Rodolfo855/ClassD/Project Pictures/IMG_4157.jpg

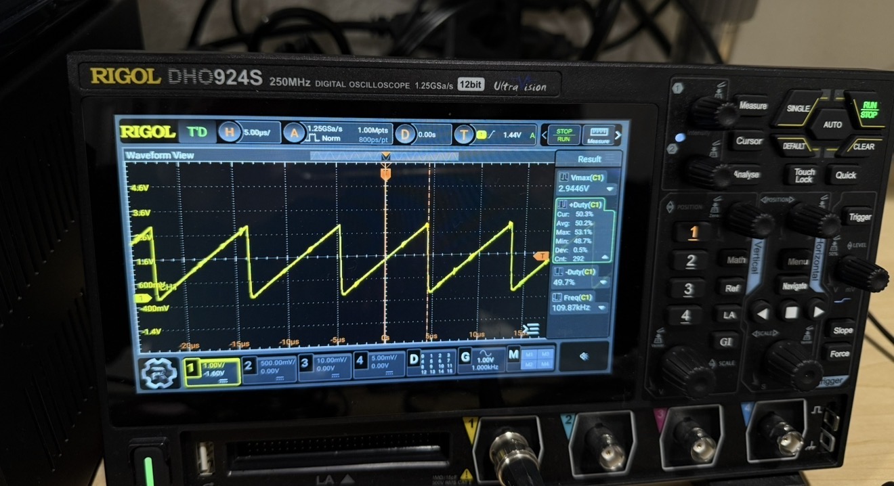
Project Pictures/IMG_4157.jpg
