Rodolfo855/ClassD/Project Pictures/IMG_4158.jpg

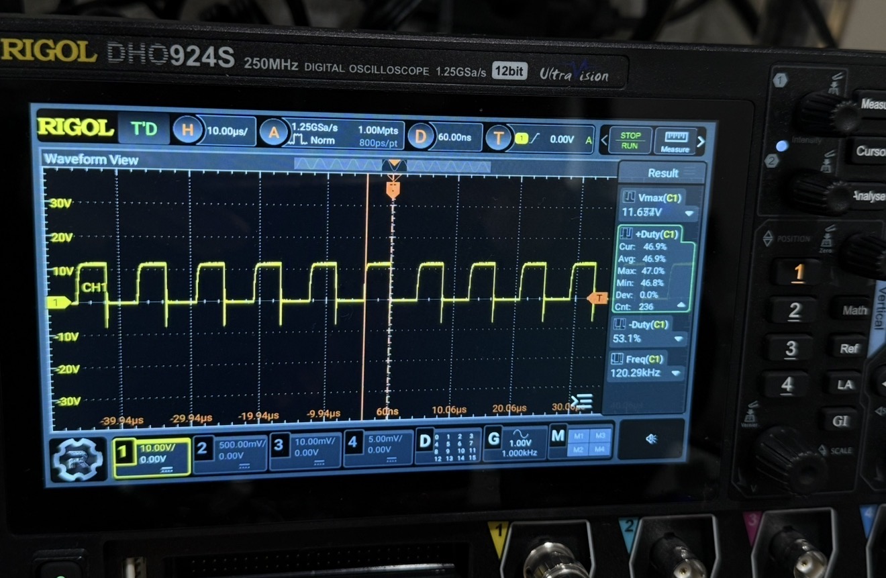
Project Pictures/IMG_4158.jpg
