Rodolfo855/ClassD/Write-Up/ENGG220 Final -Write up.pdf

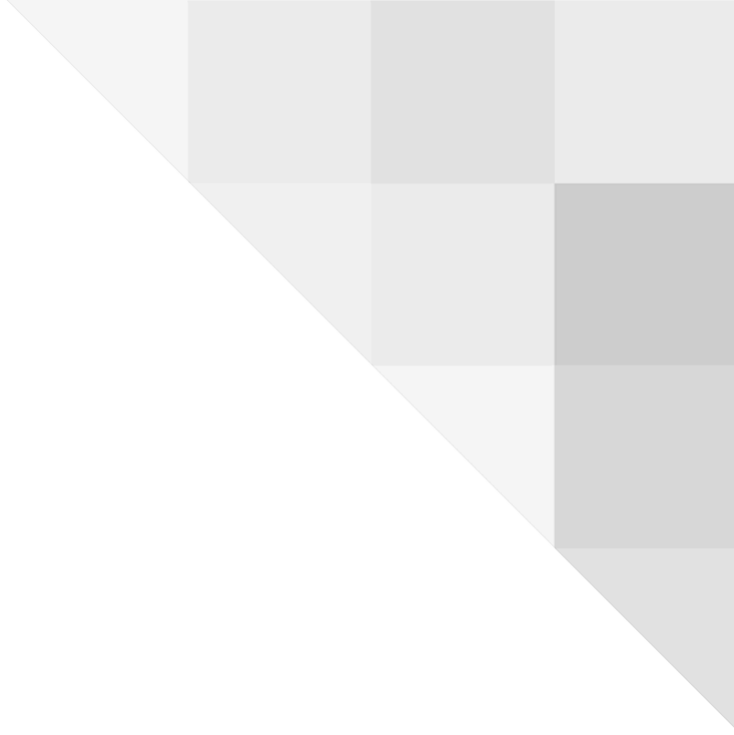
[picture p3: figure]

# Victor Rosales

College of Marin

# ENGG220 Final Project

05/11/2026

# Project Overview

For my final project I built a high-efficiency Class D Amplifier based on the Mundo Electronica design. This project required me to dive deeper into audio filtering and generation of pulse width modulation signals. In addition, I needed to calculate input impedances, components values, and bode plots using LTSpice software . Also, this project required me to read and understand data sheets for integrated circuits.

## Pulse Width Modulation (PWM)

Based on the TL494 (IC) we can generate a sawtooth signal that oscillates between 0 and 3V, which then is compared to the audio signal to generate a PWM signal. I am using a single ended approach which means I have to ground one of the emitters (E2) to get an inverse PWM. This PWM and INV_PWM will be used by the power stage and controlled by IR2110 (IC) which will then allow N-Channel MOSFETS (IRFZ44N’s) to increase the

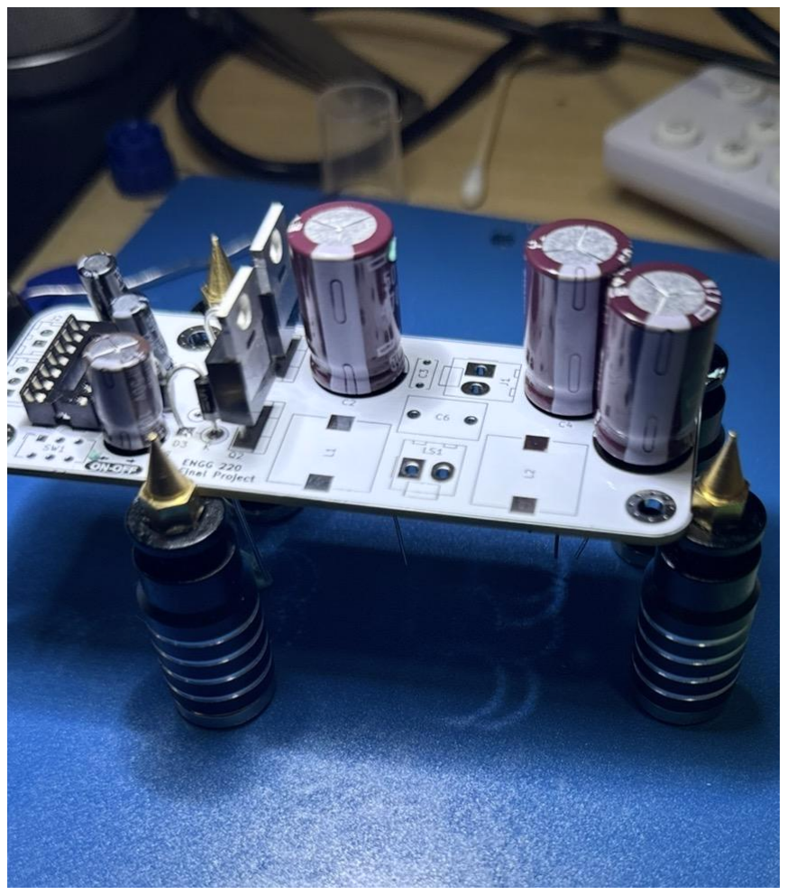
[picture p4: figure]

power output to the speaker connected. I am implementing a half-bridge topology and using a single source, which means I need a “bootstrap” circuit using IR2110 and a capacitor to give the mosfet a higher voltage than 36V (circuit max) to successfully open and close the gates.

Instructions

Given that the sawtooth generated by the TL494 oscillates between 0 and 3V we need to “submerge” or audio signal between this range. Now, there are a few ways on how to do this, but the easiest way will be to send a 1khz signal at full volume and measure with an oscilloscope the peak to peak voltage coming out of test point 7 (AUDIO). I have placed a potentiometer that will allow us to adjust the gain. When the gain is too high or above the limits of TL494 or the operational amplifier (LM358) you will experience “clipping” which I have attached a picture for you to see (and avoid).

Challenges

I used and calculated resistors that were giving me 0.1 gain for the second operational amplifier, as well as incorrect component values for high pass filters. I blew a couple of transistors and other components. Also, the audio sine wave was not oscillating between 0 and 3V it was oscillating between 2.2V and 2.6V with a peak to peak voltage of only about 400mV. I connected the IC backwards so I needed to double check pin by pin. Soldering challenges and ordering components was also a bit of a struggle and expensive.

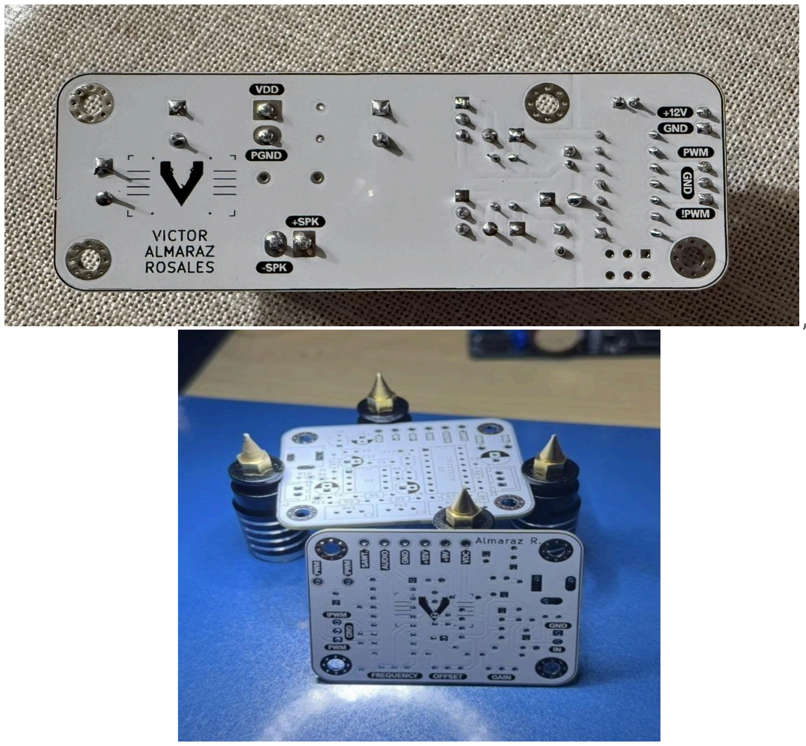
[picture p5: figure]

,

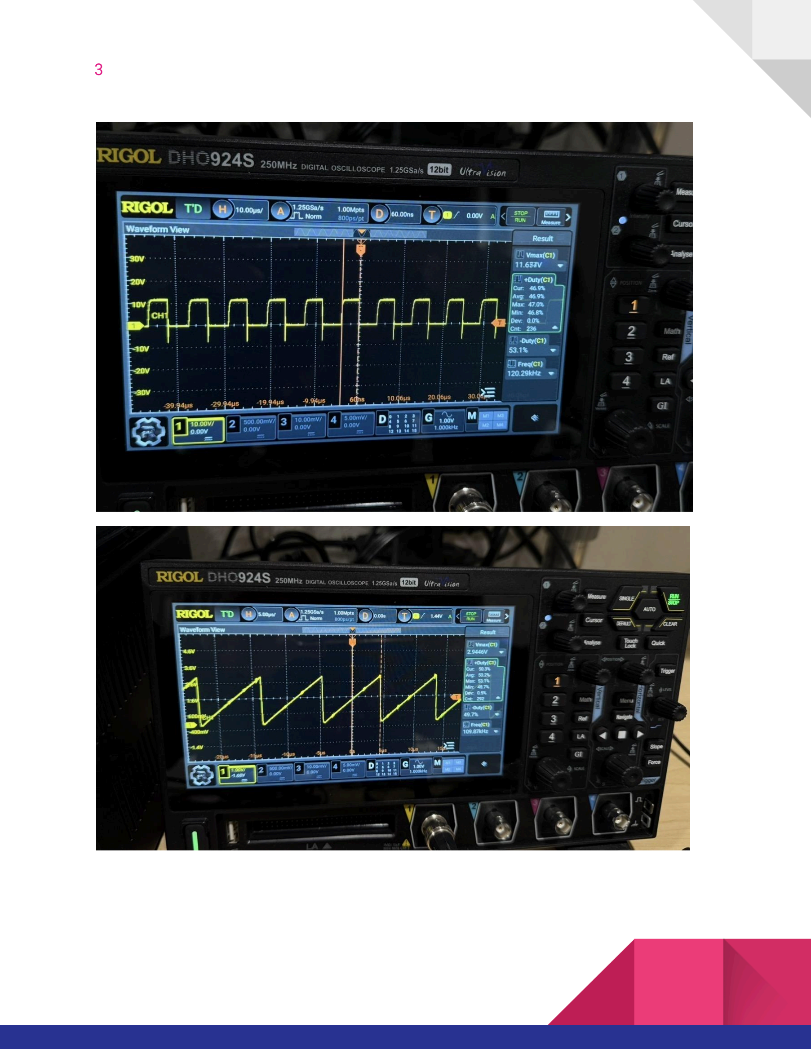
[picture p6: page 3]
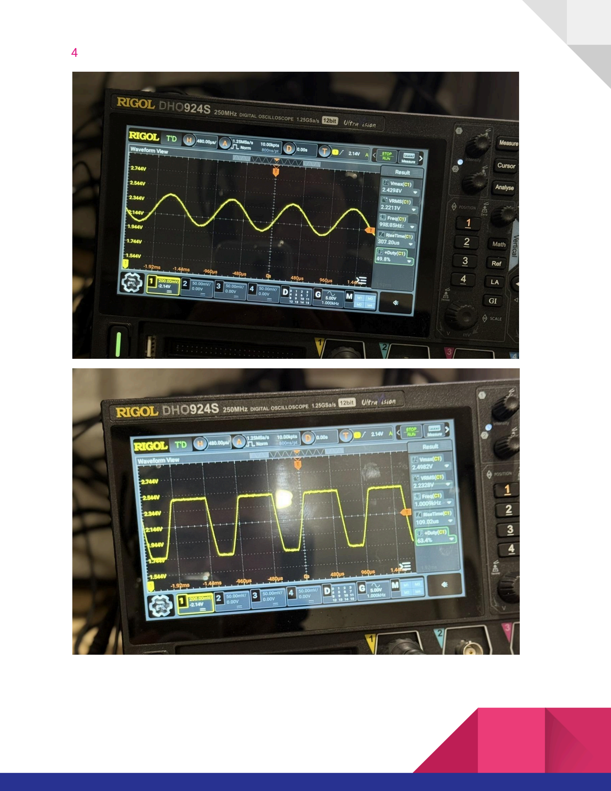
[picture p7: page 4]
