Rodolfo855/ClassD/Project Pictures/IMG_4139.jpg

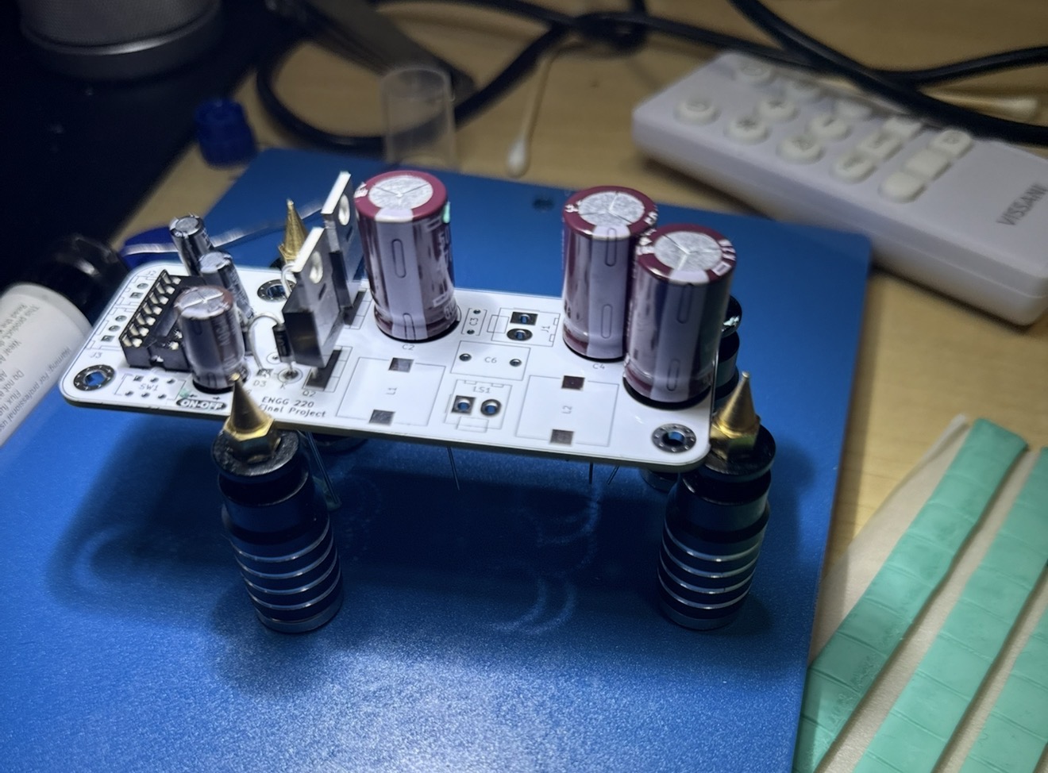
Project Pictures/IMG_4139.jpg
