Rodolfo855/ClassD/Project Pictures/IMG_4155.jpg

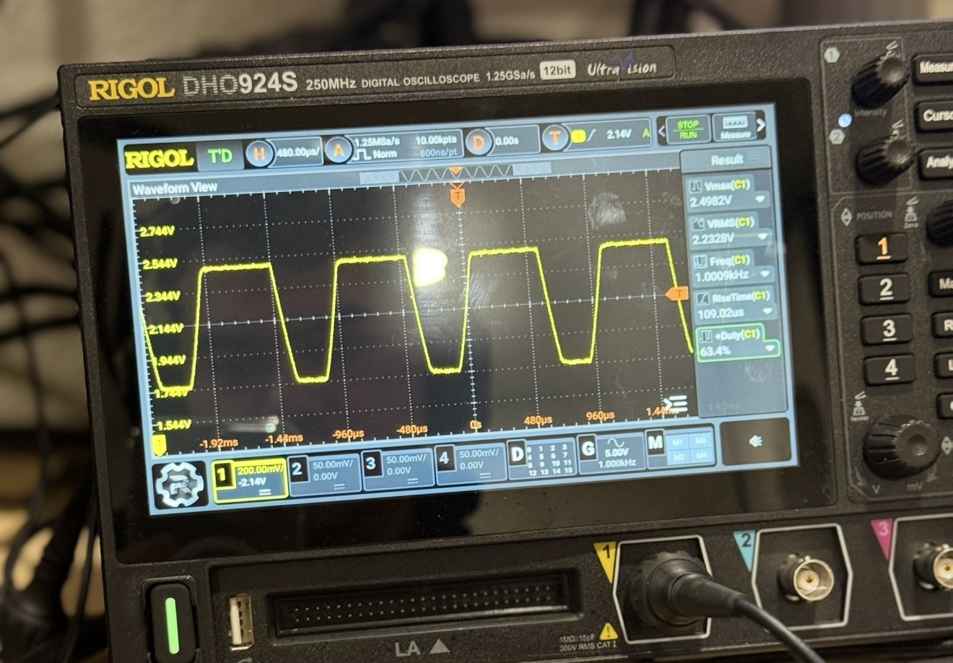
Project Pictures/IMG_4155.jpg
