Rodolfo855/ClassD/Project Pictures/IMG_4156.jpg

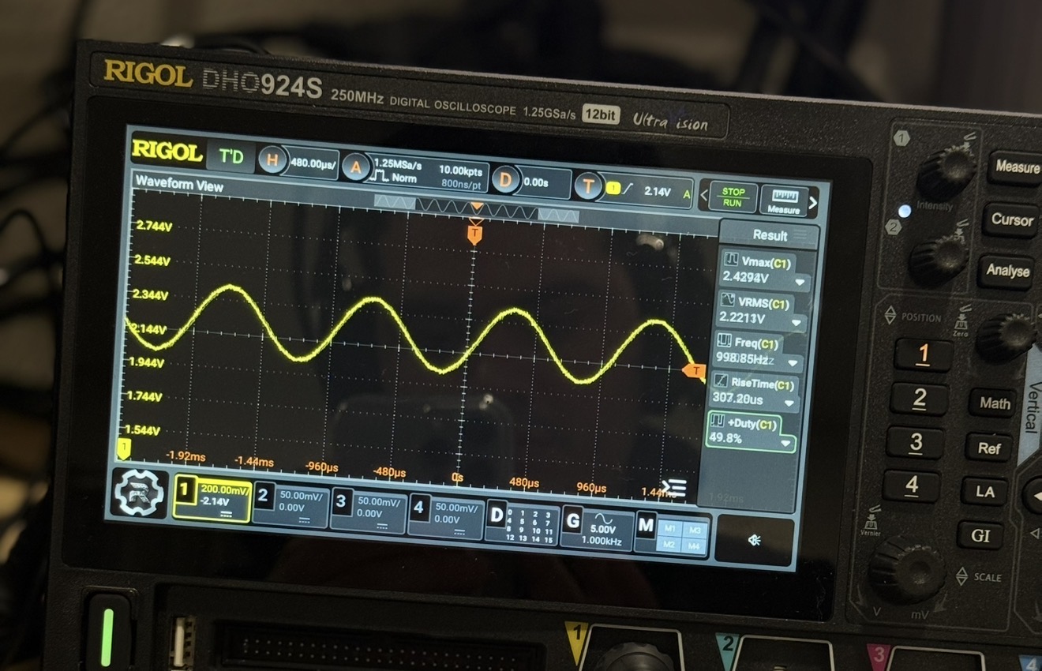
Project Pictures/IMG_4156.jpg
