Rodolfo855/ClassD/Project Pictures/IMG_4159.jpg

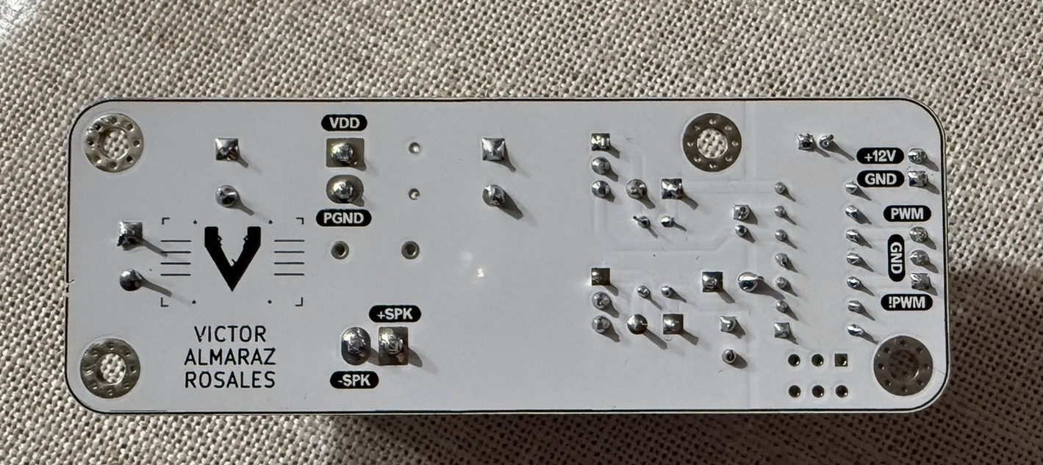
Project Pictures/IMG_4159.jpg
