Rodolfo855/ClassD/Project Pictures/IMG_4160.jpg

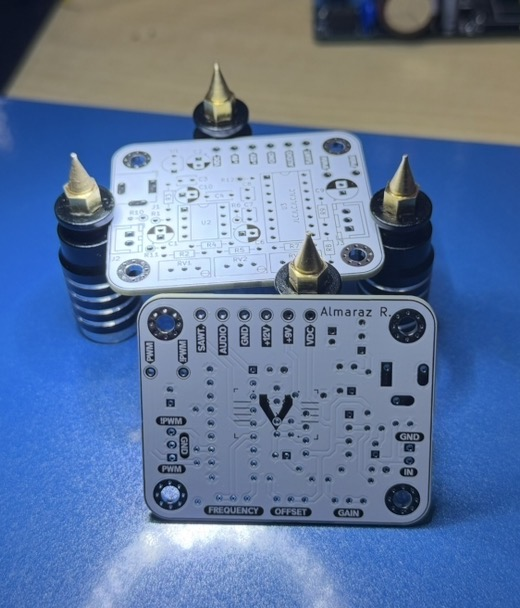
Project Pictures/IMG_4160.jpg
