Rodolfo855/ClassD/Project Pictures/Screenshot 2026-05-03 at 4.42.00 PM.png

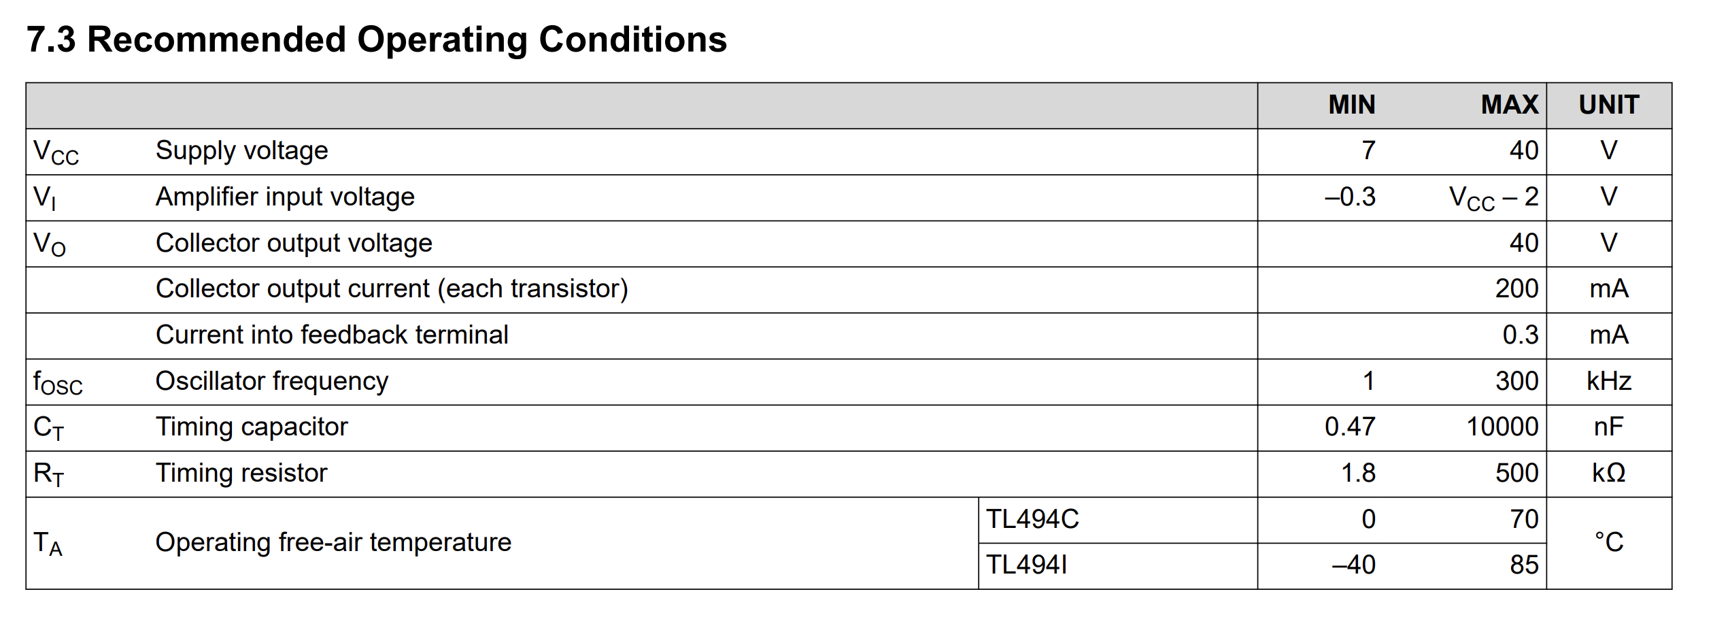
Project Pictures/Screenshot 2026-05-03 at 4.42.00 PM.png
