Rodolfo855/ClassD/Project Pictures/Screenshot 2026-05-03 at 5.14.32 PM.png

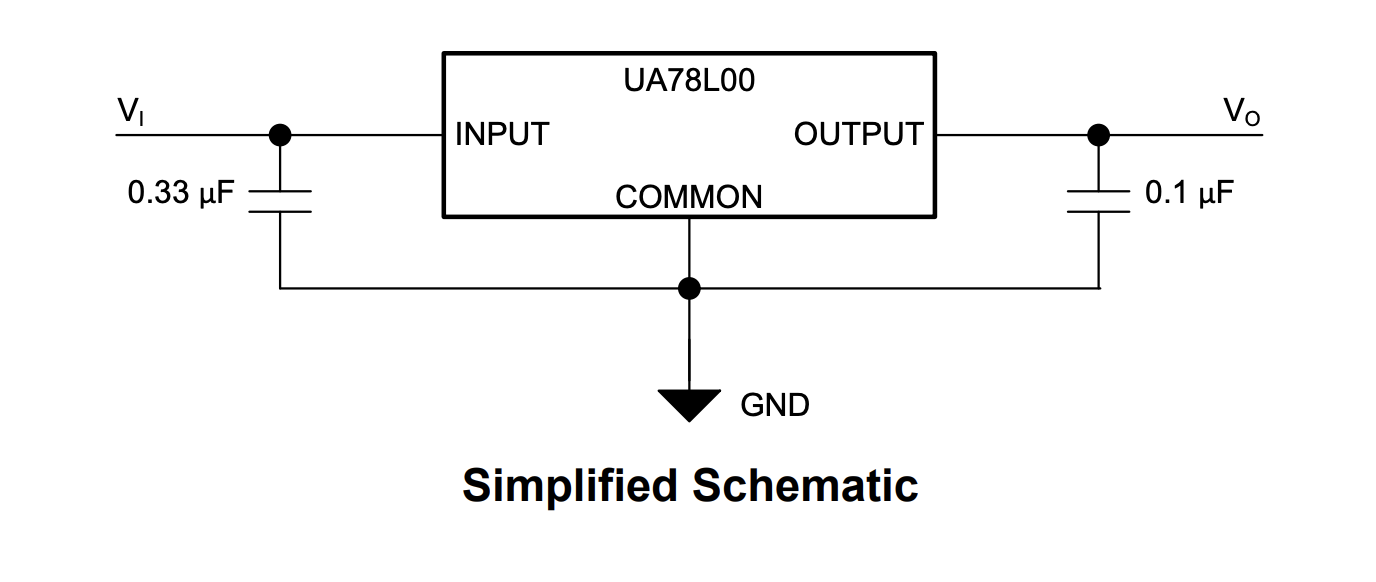
Project Pictures/Screenshot 2026-05-03 at 5.14.32 PM.png
