Rodolfo855/ClassD/Project Pictures/Screenshot 2026-05-04 002417.png

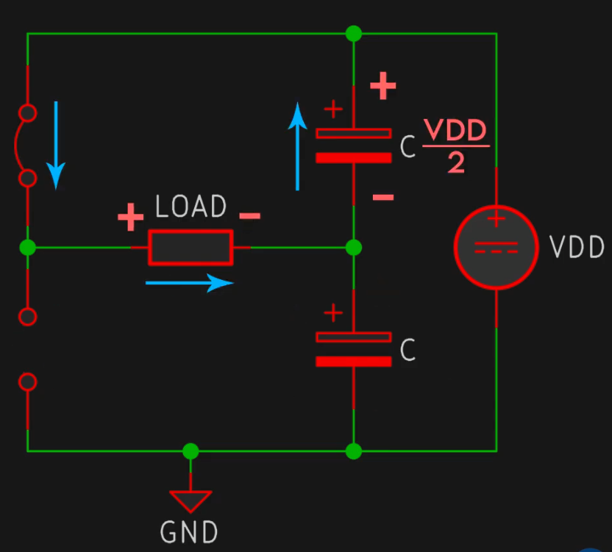
Project Pictures/Screenshot 2026-05-04 002417.png
