Rodolfo855/ClassD/Project Pictures/Screenshot 2026-05-07 at 1.02.39 AM.png

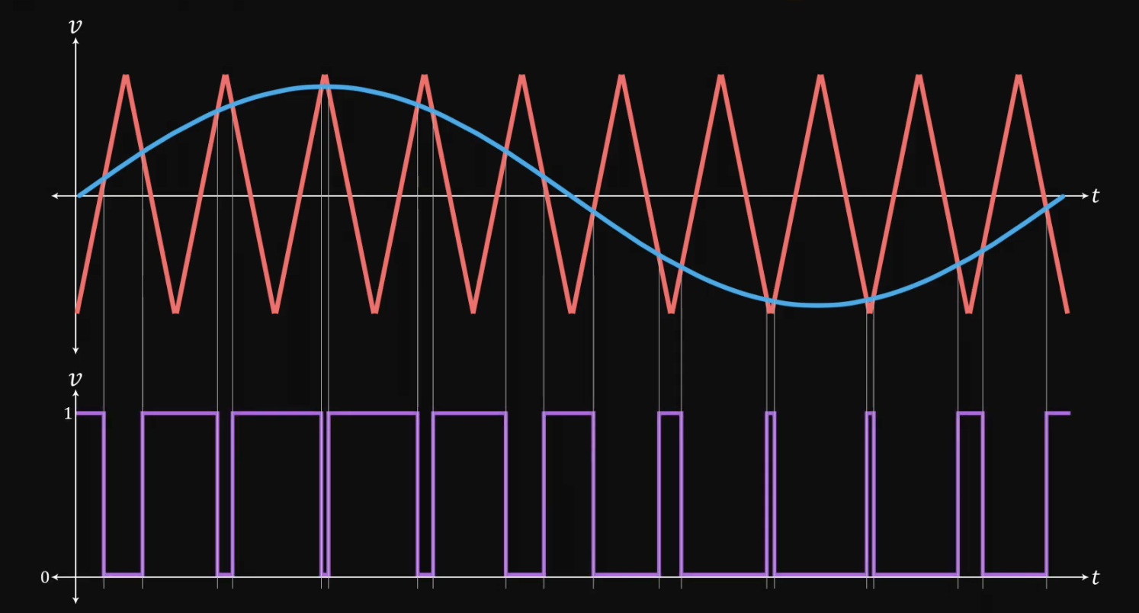
Project Pictures/Screenshot 2026-05-07 at 1.02.39 AM.png
