Rodolfo855/ClassD/Project Pictures/Screenshot 2026-05-07 at 12.59.20 AM.png

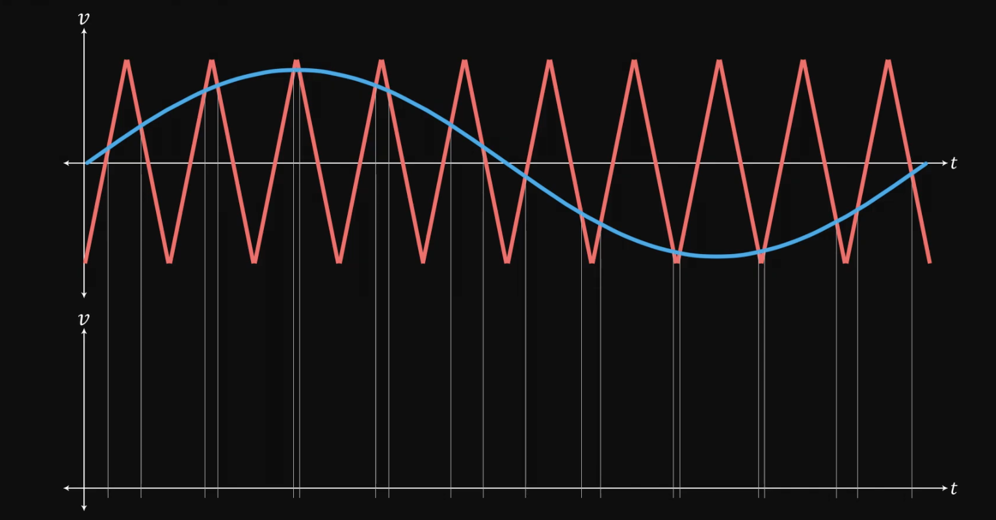
Project Pictures/Screenshot 2026-05-07 at 12.59.20 AM.png
