Rodolfo855/ClassD/PowerStage/PowerStage.pdf

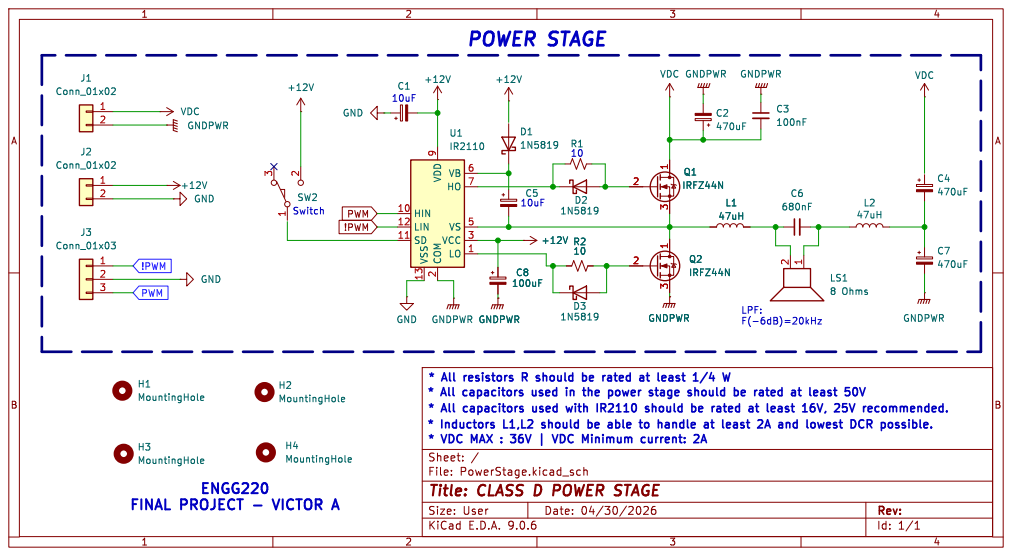
[picture p21: page 1]

2 SW2 C1 H1 MountingHole H3 MountingHole H4 MountingHole H2 MountingHole HIN 10

2 VB 6 HO 7 VS 5 VCC 3

Id: 1/1 Title: CLASS D POWER STAGE
