Rodolfo855/ClassD/LTSpice/PowerStage/Draft1.asc

B1: bv; V=V(PWM)
B2: bv; V=V(PWM_INV)
B3: bv; V=V(PWM)
B4: bv; V=V(PWM_INV)
B5: bv; V=V(PWM_INV)
B6: bv; V=V(PWM)
C1: cap; 680n
C2: cap; 470µ
C3: cap; 470µ
C4: cap; 680n
D1: diode; RB085T-60NZ
D2: diode; RB085T-60NZ
D3: diode; RB085T-60NZ
D4: diode; RB085T-60NZ
D5: diode; RB085T-60NZ
D6: diode; RB085T-60NZ
L1: ind; 47µ; Rser=1m
L2: ind; 47µ; Rser=1m
L3: ind; 47µ; Rser=1m
L4: ind; 47µ; Rser=1m
R1: res; 8
R3: res; 8
S1: sw; IRFZN44N
S2: sw; IRFZN44N
S3: sw; IRFZN44N
S4: sw; IRFZN44N
S5: sw; IRFZN44N
S6: sw; IRFZN44N
U1: LT1720
U2: LT1720
V1: Voltage; SINE(6 5 1K)
V2: Voltage; PULSE(0 12 0 1.66u 1.66u 0 3.33u)
V3: Voltage; 12V
V4: voltage; 36V
Named nets: VCC, 0, SINE, TRIANG, PWM_INV, PWM, VDD/2
.tran 50m
.model IRFZN44N SW(Ron=17.5m Roff=10Meg Vt=6 Vh=0.2 Lser=10n Vser=0)
.ic V(VDD/2)=18
.tran 3m
