Rodolfo855/ClassD/LTSpice/SpeakerFreqResponse/Draft1.asc

C1: cap; 0.68µF
L1: ind; 47µH; Rser=1m
L2: ind; 47µH; Rser=1m
R1: res; {SPK}
V1: voltage; AC 1
Named nets: 0
.step param SPK 2 24 2
.ac dec 100000 20 1Meg
