Rodolfo855/ClassD/LTSpice/FilterResponse/Draft1.asc

C1: cap; 1n
C2: Cap; 10µF
C3: Cap; 1µ
R1: res; 33k
R2: res; 22k
R3: Res; 68k
R4: Res; 22k
R5: Res; 10k
V1: voltage; AC 9
V2: Voltage; AC 9
V3: Voltage; AC 1
Named nets: 0, VREF
.ac1 dec 999999 100 1Meg
.ac dec 100 1 100k
.ac2 dec 100 1 100k
