Rodolfo855/ClassD/PreAmp/ClassD.kicad_pcb

## KiCad design PreAmp/ClassD.kicad_pcb (2026-05-04)

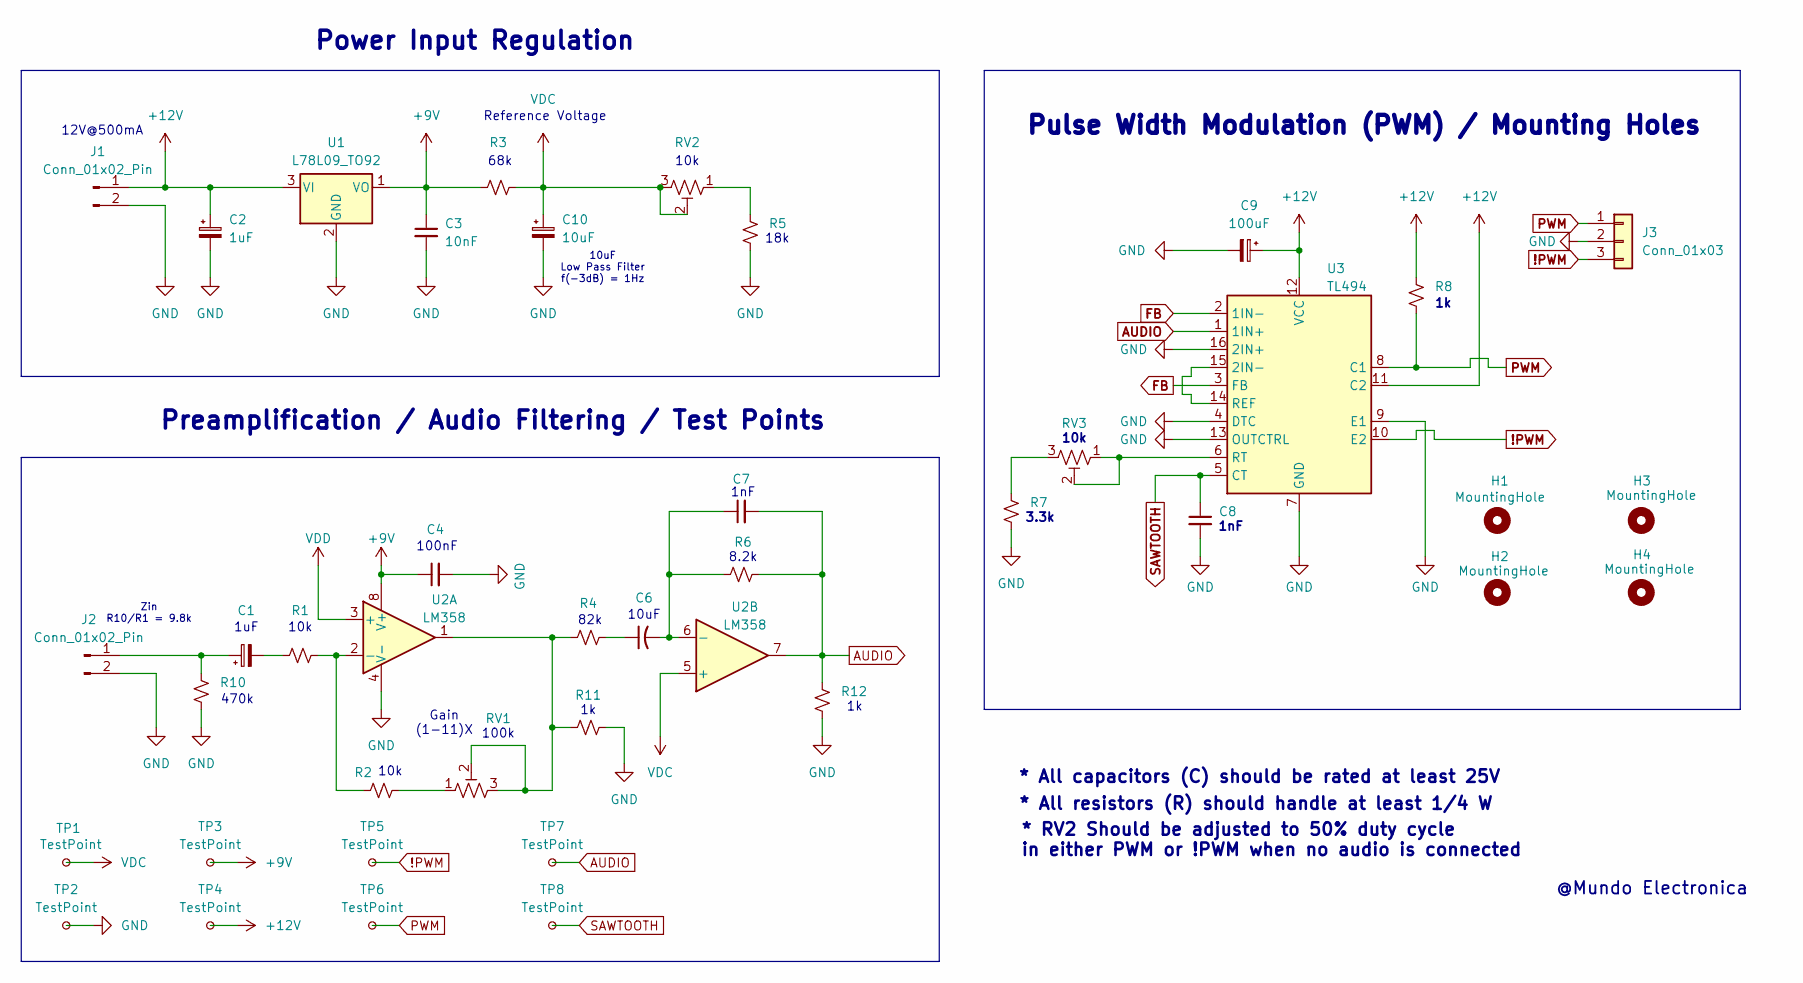
[picture p22: schematic ClassD.kicad_sch, ENGG220 Final Project - Victor Rosales]

Parts:
C1: C_Polarized_Small; CP_Radial_D5.0mm_P2.00mm
C2: 1uF; CP_Radial_D5.0mm_P2.00mm
C3: 10nF; C_Disc_D3.8mm_W2.6mm_P2.50mm
C4: C_Small; C_Disc_D5.0mm_W2.5mm_P5.00mm
C6: C_Small_US; CP_Radial_D5.0mm_P2.00mm
C7, C8: C_Small; C_Disc_D3.8mm_W2.6mm_P2.50mm
C9: 100uF; CP_Radial_D8.0mm_P3.50mm
C10: 10uF; CP_Radial_D5.0mm_P2.00mm
H1, H2, H3, H4: MountingHole; MountingHole_3.2mm_M3_Pad_Via
J1: Conn_01x02_Pin; BarrelJack_GCT_DCJ200-10-A_Horizontal
J2: Conn_01x02_Pin; JST_XH_B2B-XH-A_1x02_P2.50mm_Vertical
J3: Conn_01x03; JST_XH_B3B-XH-A_1x03_P2.50mm_Vertical
R1, R2, R3, R4, R5, R6, R7, R8, R10, R11, R12: R_Small_US; R_Axial_DIN0204_L3.6mm_D1.6mm_P7.62mm_Horizontal
RV1, RV2, RV3: R_Potentiometer_Trim_US; Potentiometer_Bourns_3296W_Vertical
TP1, TP2, TP3, TP4, TP5, TP6, TP7, TP8: TestPoint; TestPoint_THTPad_D2.0mm_Drill1.0mm
U1: L78L09_TO92; TO-92_Inline_Wide
U2: LM358; DIP-8_W7.62mm_Socket
U3: TL494; DIP-18_W7.62mm_Socket

Connections:
!PWM: J3.3, TP5.1, U3.10 (E2)
+9V: C3.1, C4.1, R3.1, TP3.1, U1.1 (VO), U2.8 (V+)
+12V: C2.1, C9.1, J1.1, R8.1, TP4.1, U1.3 (VI), U3.11 (C2), U3.12 (VCC)
AUDIO: C7.2, R6.2, R12.1, TP7.1, U2.7, U3.1 (1IN+)
FB: U3.2 (1IN-), U3.3 (FB)
GND: C2.2, C3.2, C4.2, C8.2, C9.2, C10.2, J1.2, J2.2, J3.2, R5.2, R7.2, R10.2, R11.2, R12.2, TP2.1, U1.2 (GND), U2.4 (V-), U3.4 (DTC), U3.7 (GND), U3.9 (E1), U3.13 (OUTCTRL), U3.16 (2IN+)
unnamed: C1.2, R1.1
unnamed: C6.1, R4.2
unnamed: C1.1, J2.1, R10.1
unnamed: R2.2, RV1.1
unnamed: R5.1, RV2.1
unnamed: R7.1, RV3.3
unnamed: R4.1, R11.1, RV1.2, RV1.3, U2.1
unnamed: R1.2, R2.1, U2.2 (-)
unnamed: C6.2, C7.1, R6.1, U2.6 (-)
unnamed: U3.14 (REF), U3.15 (2IN-)
unnamed: RV3.1, RV3.2, U3.6 (RT)
PWM: J3.1, R8.2, TP6.1, U3.8 (C1)
SAWTOOTH: C8.1, TP8.1, U3.5 (CT)
VDC: C10.1, R3.2, RV2.2, RV2.3, TP1.1, U2.5 (+)
VDD: U2.3 (+)

Notes on the sheet:
Pulse Width Modulation (PWM) / Mounting Holes
3.3k
Power Input Regulation
1nF
* All capacitors (C) should be rated at least 25V
100k
Reference Voltage
470k
1uF
10k
10uF Low Pass Filter f(-3dB) = 1Hz
* All resistors (R) should handle at least 1/4 W
@Mundo Electronica
68k
* RV2 Should be adjusted to 50% duty cycle in either PWM or !PWM when no audio is connected
Preamplification / Audio Filtering / Test Points
8.2k
12V@500mA
18k
Zin R10/R1 = 9.8k
82k
Gain (1-11)X
10uF
100nF

Board: 2 copper layers, 41 parts (0 on the bottom side), 20 nets, no tracks yet.
