Rodolfo855/ClassD/(commit log)

2026-04-29 Init Class D repo
    [ClassD.kicad_pcb, ClassD.kicad_sch]
2026-04-30 Added audio input
    [ClassD.kicad_sch]
2026-04-30 Finished Schematic Class D
    [ClassD.kicad_sch]
2026-04-30 Added PDF file for schematic
2026-04-30 init power stage
    [ClassD.kicad_pcb, ClassD.kicad_sch, PowerStage.kicad_pcb, PowerStage.kicad_sch]
2026-05-03 Finished power stage
    [PowerStage.kicad_sch]
2026-05-03 Fixed routing
    [PowerStage.kicad_pcb, PowerStage.kicad_sch]
2026-05-03 Created schematic pdf
    [PowerStage.kicad_sch]
2026-05-04 Renamed pre amp input regulation
    [ClassD.kicad_sch]
2026-05-04 Assigned footprints to all components in Pre Amplification Stage
    [ClassD.kicad_pcb, ClassD.kicad_sch]
2026-05-04 Fixed audio jack to 2 pins
    [ClassD.kicad_pcb, ClassD.kicad_sch]
2026-05-04 Added Filter Atenuation Response Simulation
2026-05-05 Added low pass/high pass filter simulations
2026-05-12 Added pictures, and write-up
    [ClassD.kicad_sch]
2026-05-19 Fixed gain on second op-amp
    [ClassD.kicad_sch]
2026-06-10 Added gerber files
    [Class D Potencia-B_Cu.gbr, Class D Potencia-B_Mask.gbr, Class D Potencia-B_Paste.gbr, Class D Potencia-B_Silkscreen.gbr, Class D Potencia-Edge_Cuts.gbr, Class D Potencia-F_Cu.gbr, Class D Potencia-F_Mask.gbr, Class D Potencia-F_Paste.gbr]
2026-06-25 Fixed R9 and pdf
    [ClassD.kicad_sch]
